TimMJN/Arduino-Morse-Gate-Generator/arduino_morse_gate_generator_schematic/arduino_morse_gate_generator_BOM.pdf

Id | Designator | Quantity | Designation | Supplier and ref
| 1 A1 | | 1 Arduino_Nano
| 2 A2 | | 1 SD_CARD_MODULE | SPI SD card module
| 3 C1,C5,C7 | | 3 100nF | Ceramic disk
| 4 C4 | | 1 330nF | Electrolytic
| 5 C6 | | 1 10uF | Electrolytic
| 6 D1,D3 | | 2 LED
| 7 D2 | | 1 1N5817 | Schottky diode
| 8 J1,J2 | | 2 AudioJack2 | Mono jack
| 9 J3 | | 1 Conn_02x05 | Box header
| 10 Q1,Q2 | | 2 2N3904 | Signal diode
| 11 R1,R3,R9 | | 3 1k | 1/4 W
| 12 R2,R6,R8 | | 3 10k | 1/4 W
| 13 R4 | | 1 100k | 1/4 W
| 14 R5 | | 1 1M | 1/4 W
| 15 R7 | | 1 100R | 1/4 W
| 16 R10 | | 1 10R | 1/4 W
| 17 RV1 | | 1 B100k | 100k linear taper
| 18 SW1 | | 1 SW_Push | Momentary push button
| 19 SW2 | | 1 SW_SPST | SPST switch
| 20 U2 | | 1 L78L05 | 5v regulator
