TimMJN/Arduino-Morse-Gate-Generator/arduino_morse_gate_generator_schematic/arduino_morse_gate_generator_schematic.pdf

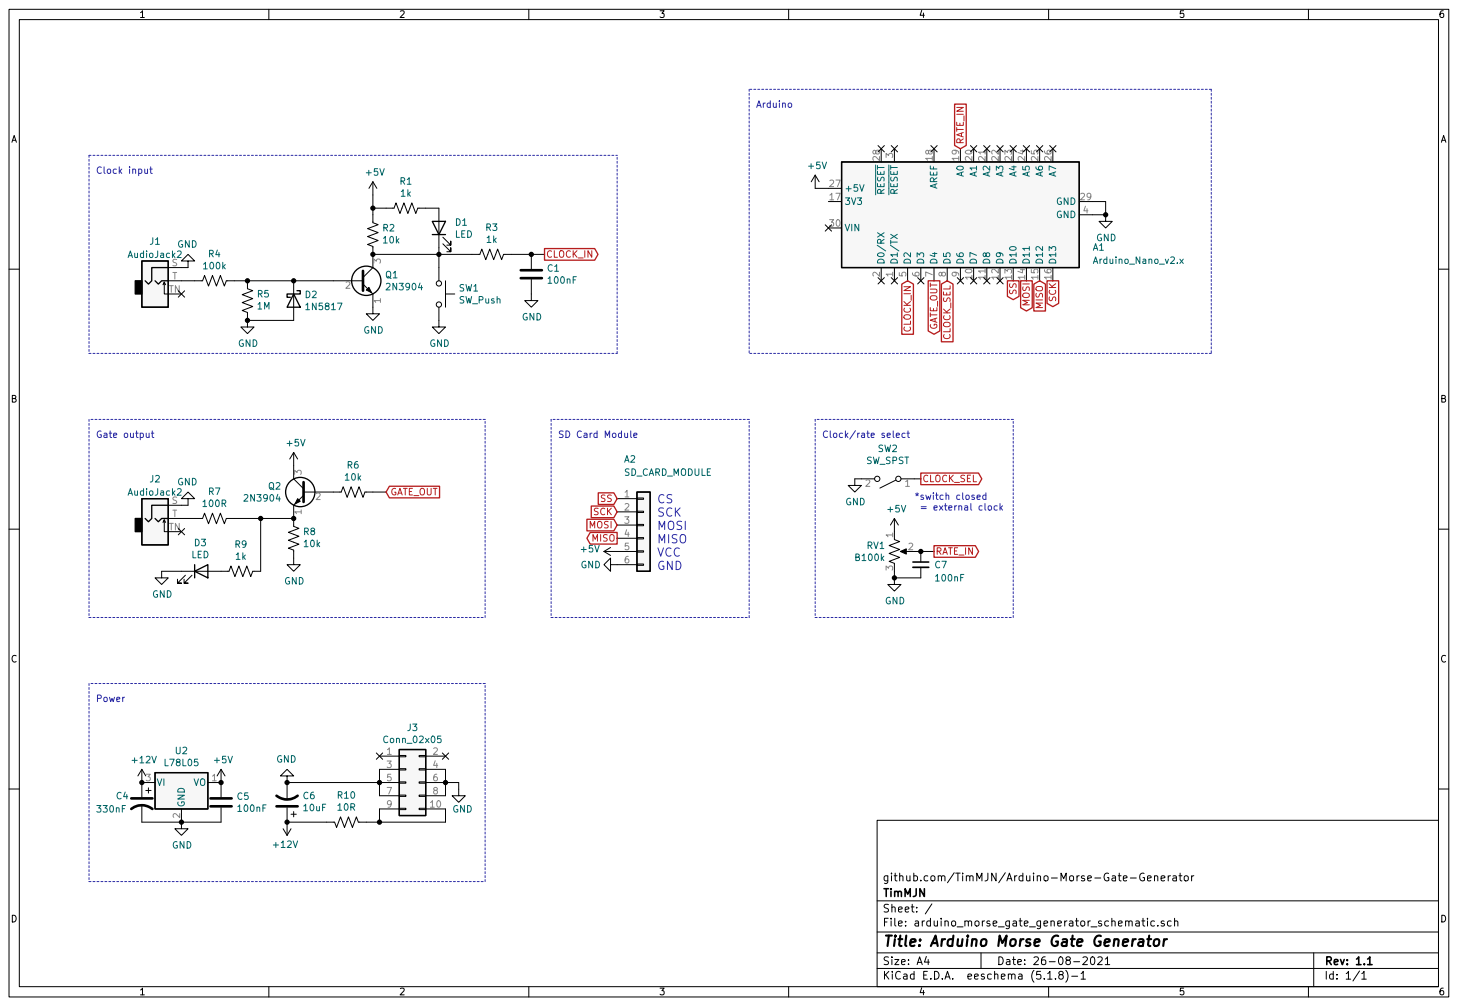
[picture p1: page 1]

= external clock Clock input
J1 AudioJack2S

github.com/TimMJN/Arduino-Morse-Gate-Generator GND

File: arduino_morse_gate_generator_schematic.sch Sheet: / TimMJN

Id: 1/1 Title: Arduino Morse Gate Generator
