TimMJN/Arduino-Morse-Gate-Generator/(commit log)

2021-01-11 added schematic
2021-01-14 replace float math with unsigned longs
    [arduino_morse_gate_generator_firmware.ino]
2021-01-14 Added printing of files, rejection of consecutive whitespaces
2021-01-14 clarified clock switch direction
2021-01-14 added a smoothing capacitor to the rate pot
2021-01-16 Added capacitor values
2021-01-16 added BOM
2021-06-19 moved TimerOne
